s21rc/Arduino-LDMOS-SSPA-Controller/PCB/readme

PCB V1.6.1 is compatible with following software:
Code V1.x
Code V2.0.x
Code V2.1.x
