s21rc/Arduino-LDMOS-SSPA-Controller/connectivity-diagram-1.1.png

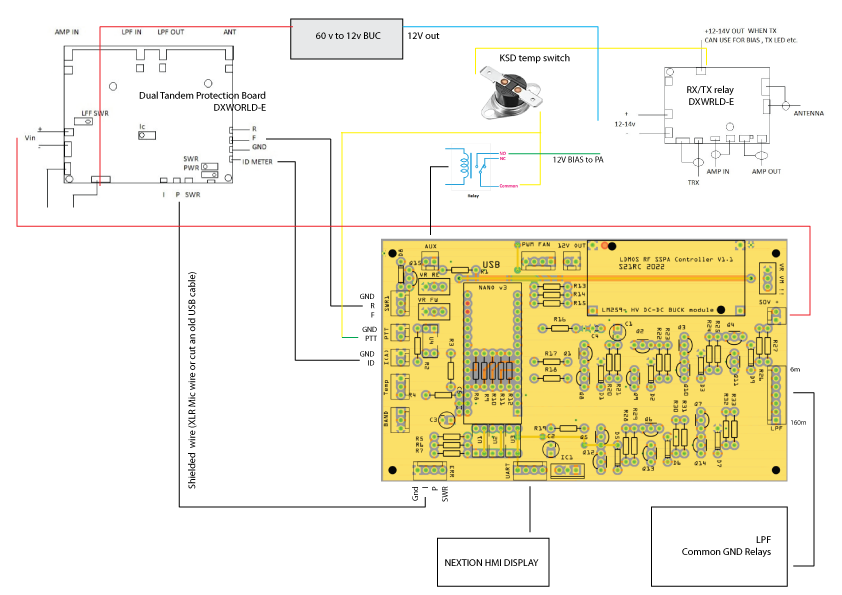
connectivity-diagram-1.1.png
