s21rc/Arduino-LDMOS-SSPA-Controller/Corrected - Schemetic LDMOS-SSPA-Controller-v1.3.png

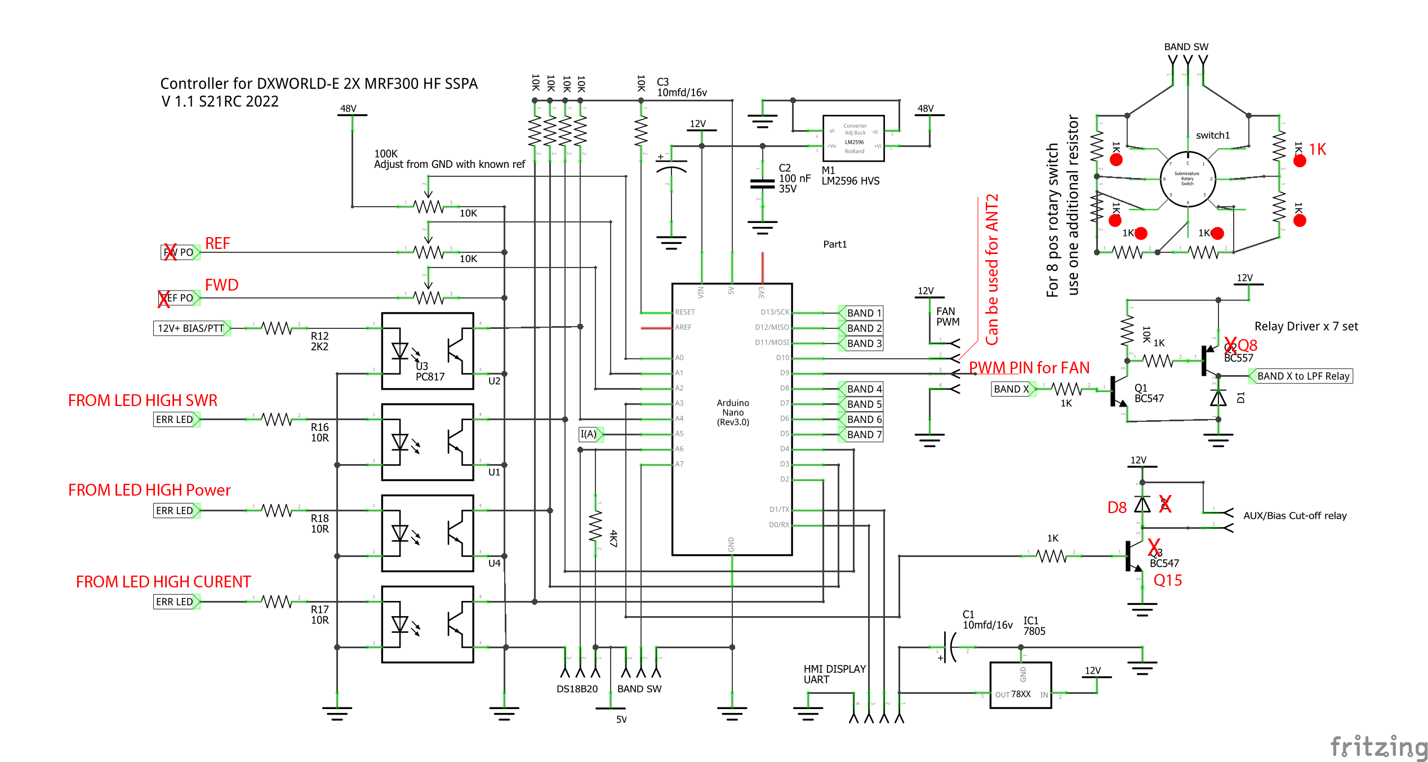
Corrected - Schemetic LDMOS-SSPA-Controller-v1.3.png
