s21rc/Arduino-LDMOS-SSPA-Controller/S21RC nextion ldmos controller.PNG

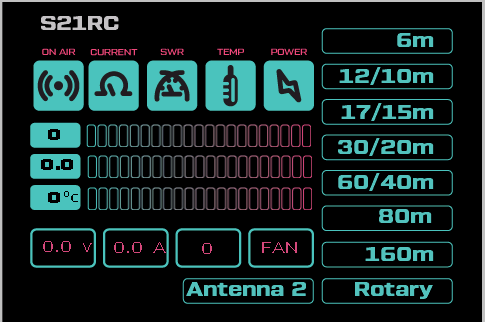
S21RC nextion ldmos controller.PNG
