s21rc/Arduino-LDMOS-SSPA-Controller/parts layout.png

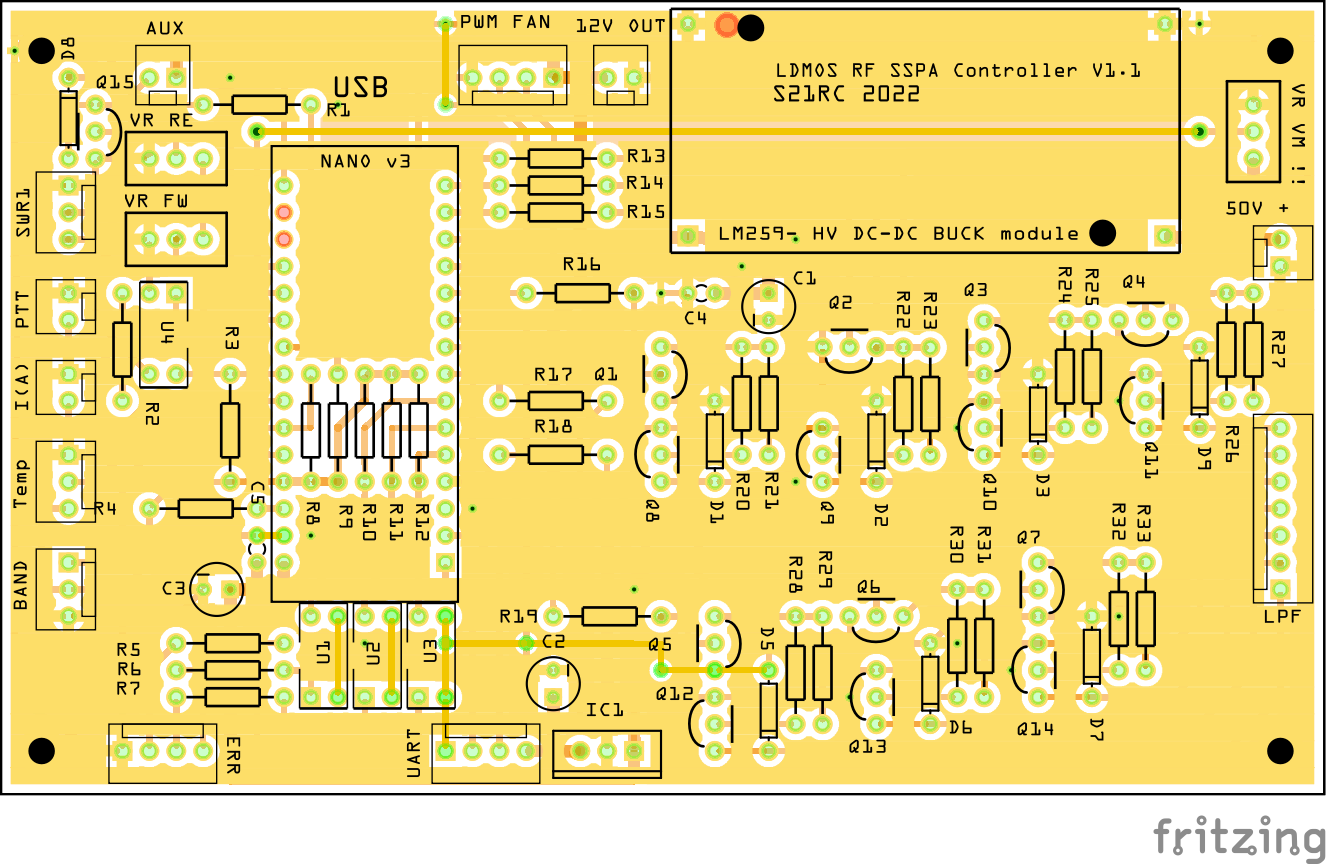
parts layout.png
