s21rc/Arduino-LDMOS-SSPA-Controller/Schemetic for PCB V1.3 S21RC Drawn by DF1JM.pdf

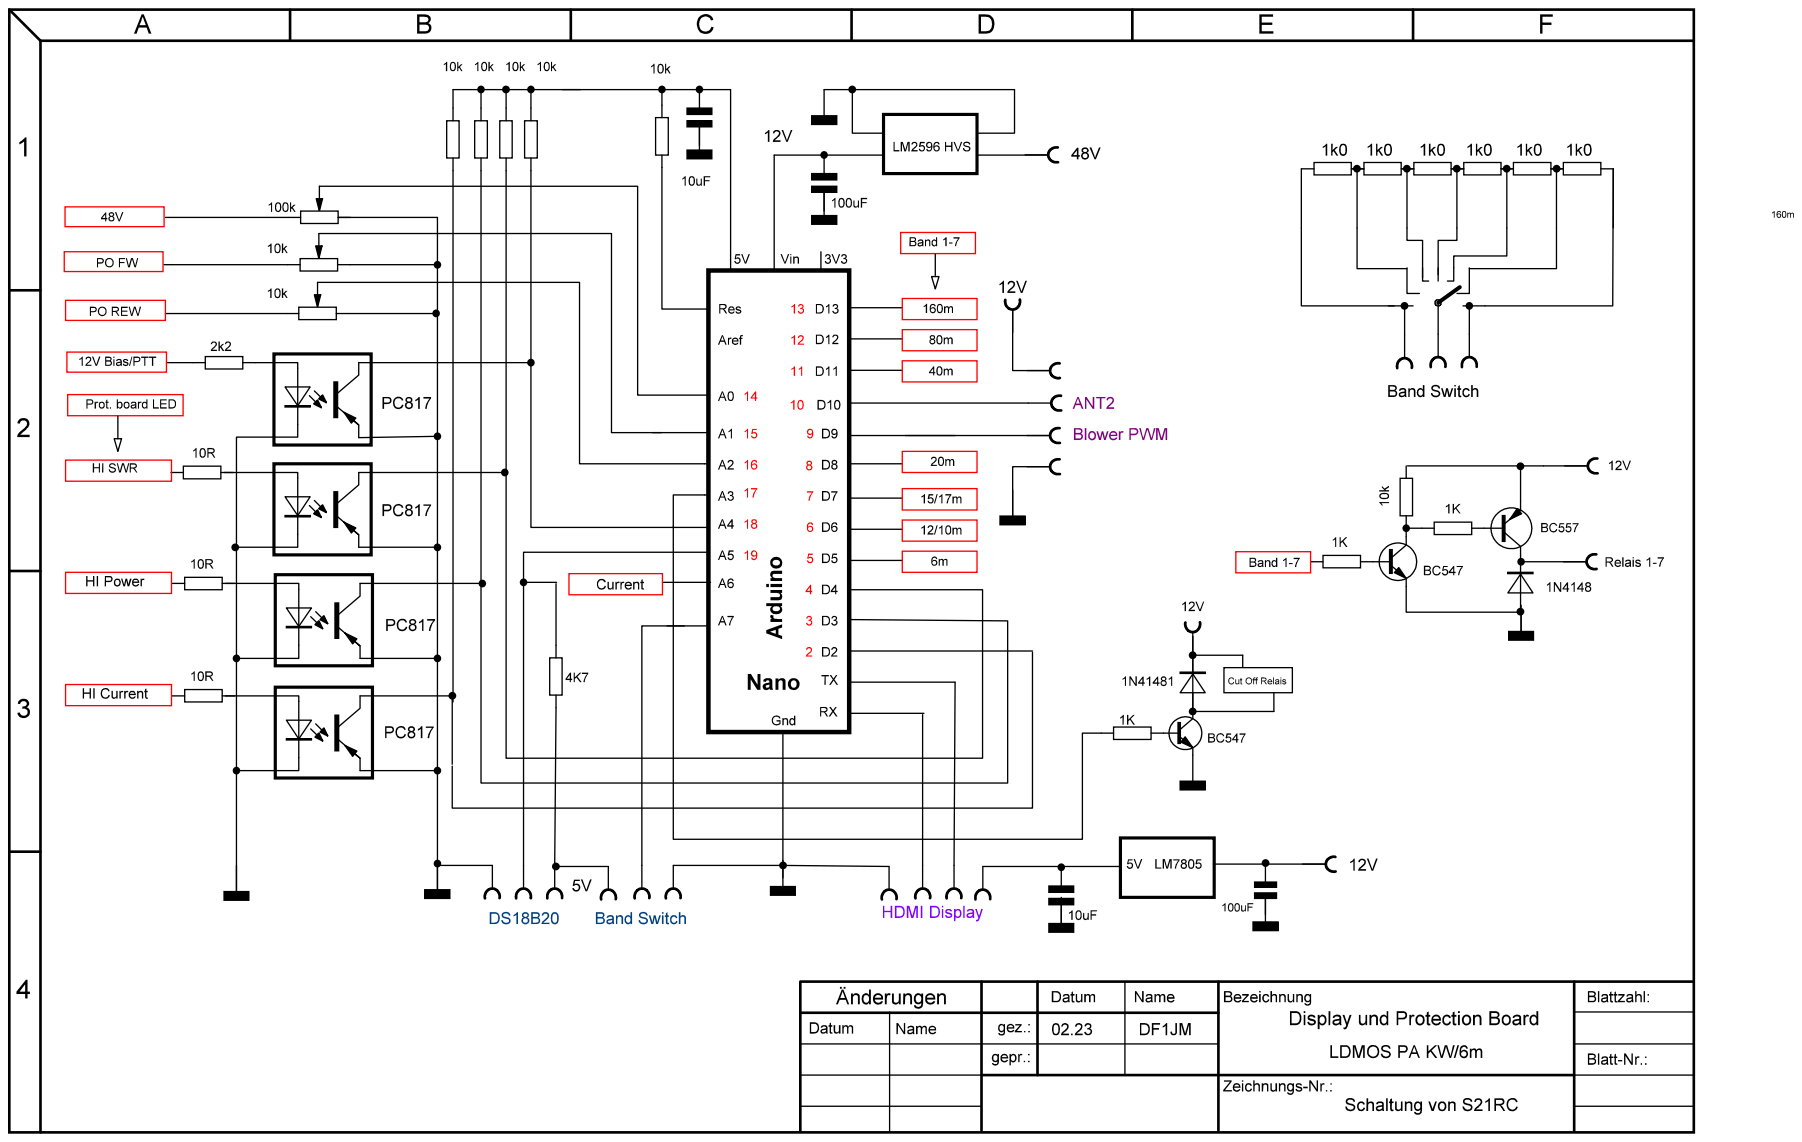
[picture p9: page 1]
