s21rc/Arduino-LDMOS-SSPA-Controller/(threads)

Thread 1 (2022-08-17):

Librairy to compile

RF-TEC, 2022-08-17:
hello

I would like to congratulate you on your work.

Beyond all considerations, wishing to proceed with the compilation,
could you please indicate precisely the required libraries
to be attached, as well as the links to obtain them.

Will these headers be sufficient or is there more code to include ?
```
<EEPROM.h>
<OneWire.h>
<DallasTemperature.h> //https://github.com/milesburton/Arduino-Temperature-Control-Library
<math.h>
<EasyNextionLibrary.h> // https://github.com/Seithan/EasyNextionLibrary
```

Thanks for your support

RF-TEC, 2022-08-17:
Thanks for your feedback

I have the following headers installed

OneWire.h
DallasTemperature.h
EasyNextionLibrary.h

But I encounter an basical error during compilation with the absence of the header nrf.h related to EEPROM.h library

```
In file included from ../NVRAM.h:21:0,
                 from ../EEPROM.h:25,
                 from ../Arduino-LDMOS-SSPA-Controller-v1.4.ino:16:
../Flash.h:28:17: fatal error: nrf.h: No such file or directory
 #include <nrf.h>
```

I compile directly with Proteus ISIS and the present and functional libraries for Nano rev3.

What do you think?

Thanks
F4APX

s21rc, 2022-08-17:
Hi Frederic,
I am not used to using proteus and simulation. The function of the EEPROM is to write the band when ever it get changed. So next time you turn on the system, it loads the last position from memory. For test purpose do bellow:

Pls  comment out all three line related to EEPROM.
and add  like below before line 758 in setup. This will set the current band to 1 when first time arduino runs.

//EEPROM.get(0, current_band); // Load last band position to current_band variable from memory location 0
current_band=1;
lpf_relay(current_band);
display_band(current_band);
}

s21rc, 2022-08-18:
nrf.h is not directly related to this code, maybe it's some kind of dependency of EEPROM.h for the simulation software you are using. In my computer there is no such file (search do not get anything).

And NRF is for a different chipset. make sure you selected Nano V3 with Atmel 328 microcontroller.

RF-TEC, 2022-08-18:
Hello

Absolutely, this is an error related to the configuration of the project with the IDE integrated into Proteus, it is necessary to configure the project including the µC as soon as it is created and not to start from a blank page and configure during of compiling.

This allows to include the required resources and to perform the configuration of the µC, so all you have to do is include the headers in the pre-configured header and paste the code in the dedicated section.

It should be fine

Thanking you for your support

I will inform you if you wish of the good progress and the follow-up given to the project,
and will gladly follow the evolution of your work on your page.

Wishing you a nice day

73, Frederic
F4APX

Closed 2022-08-18.

Thread 2 (2022-08-18):

antenna 2

RF-TEC, 2022-08-18:
Hi

By compiling under the Arduino IDE v1.8.19,  an error related to "antenna2" appeared.

I looked at the code, but I can't explain the reason, please would you know what it is?

```
Arduino-LDMOS-SSPA-Controller-v1.4:684:18: error: 'antenna2' was not declared in this scope
     digitalWrite(antenna2, HIGH);
```

s21rc, 2022-08-18:
Sorry my bad (I commented that as I do not have 2 antennas), please uncomment the line 43:

//#define antenna2 10 //Antenna 2 relay pin of arduino

to:
#define antenna2 10 //Antenna 2 relay pin of arduino

RF-TEC, 2022-08-19:
Hello,

it's solved, everything is in order.

Thanks.

Closed 2022-08-19.

Thread 4 (2023-03-03):

Need help about .tft files

F8GHE, 2023-03-03:
Hi,

Is it possible to have help about the Nextion .tft files? Is it possible to modify them ? If yes, how to do ?
Thanks and regards.

73s Christian F8GHE

s21rc, 2023-03-04:
The TFT file can not be changed, you need the source HMI file. If minor changes (or display model change) you can tell me and I can try to modify it for you. If you wish to do large changes, you can do that using Nextion HMI editor (pls drop me an email to get the HMI file).

F8GHE, 2023-03-04:
Hi Fazlay, Thanks very much for your reply. I'm a beginner with the
Nextion display with their .hmi and .tft files.
In a first time I would like to add a CAT band decoder to my amplifier.
It means that I have to had this option to the display.
It could be a button "CAT/Switch" with the band selection from CAT in
parallel to the Band Switch resistor.
An ESP32 project on Github is able to decode the BAND from ICOM, YAESU
and KENWOOD CAT.
I'm going to send an Email to you to get the HMI file and try to explain
my idea.

73s Christian F8GHE

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

Kpacu07, 2023-10-24:
Hi S21RC ,
I apologize for my ignorance. My question is - can I use the tft files for NX4832T035 on an NX4832F035 display. As far as I understand the tft file should be saved on a sd card. Is that correct? Thank you.

73's de LZ5KR

hemnath009, 2025-01-12:
I have tft file
But I don't have HMI file
I need to change small things
Just remove the word
It not a button or page
Only word it is possible

s21rc, 2025-01-12:
> I have tft file But I don't have HMI file I need to change small things Just remove the word It not a button or page Only word it is possible

Hello Hemnath, please use the V2.1-Lite version (https://github.com/s21rc/ldmos_sspa_controller_v2.1_lite) as V1 is no longer updated and V2 has much more bug fixes. The HMI is there as well.

Thanks, 73, S21RC

hemnath009, 2025-01-12:
This is the tft file
I need to earse (easy homemade projects) would you help me

On Sun, 12 Jan, 2025, 10:37 am Fazlay Rabby S21RC, ***@***.***>
wrote:

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

Closed 2025-01-12.
