s21rc/Arduino-LDMOS-SSPA-Controller/(commit log)

2022-08-08 Create Arduino-LDMOS-SSPA-Controller-v1.4.ino
    PIN assignment corrected for PCB board V1.1
2022-08-18 Update Arduino-LDMOS-SSPA-Controller-v1.4.ino
    Antenna 2 error was due to not defining antenna2 var, corrected by removing the "comment // on line 43"
2022-08-25 Parts layout for PCB without silkscreen marking (Home brew)
2022-08-30 Add files via upload
    bug fixed on v1.4
    [Arduino-LDMOS-SSPA-Controller-v1.5.ino]
2023-02-15 Typical connection diagram
    An example of which ports connects what. I have tested this controller with DXWorld-E Dual Tandem and also with Single protection board.
2023-03-01 Fresh Schematic done by DF1JM
2023-03-09 Typical connection wiring
2023-12-01 PCB Gerber
